AndrewJNg/Micromouse/99_Archieved/Micromouse/MicroMouse Wall/Wall Detector.jpg

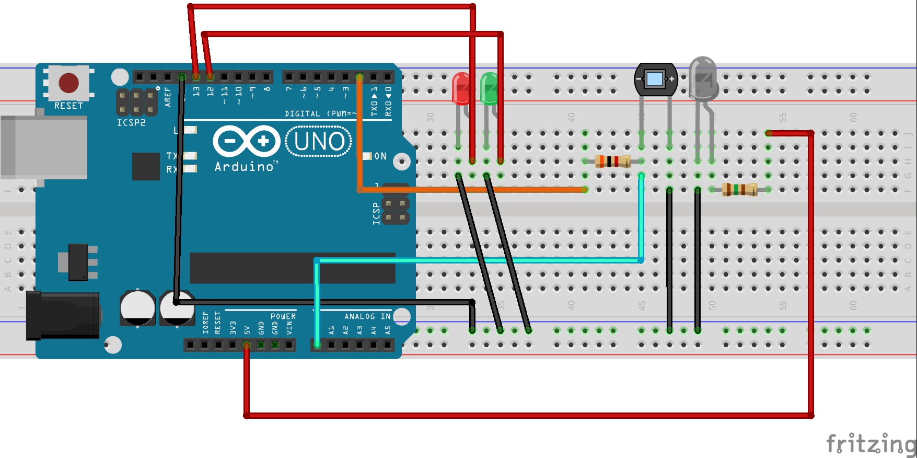
99_Archieved/Micromouse/MicroMouse Wall/Wall Detector.jpg
