AndrewJNg/Micromouse/99_Archieved/Micromouse/MicroMouse Line/Line Detector.jpg

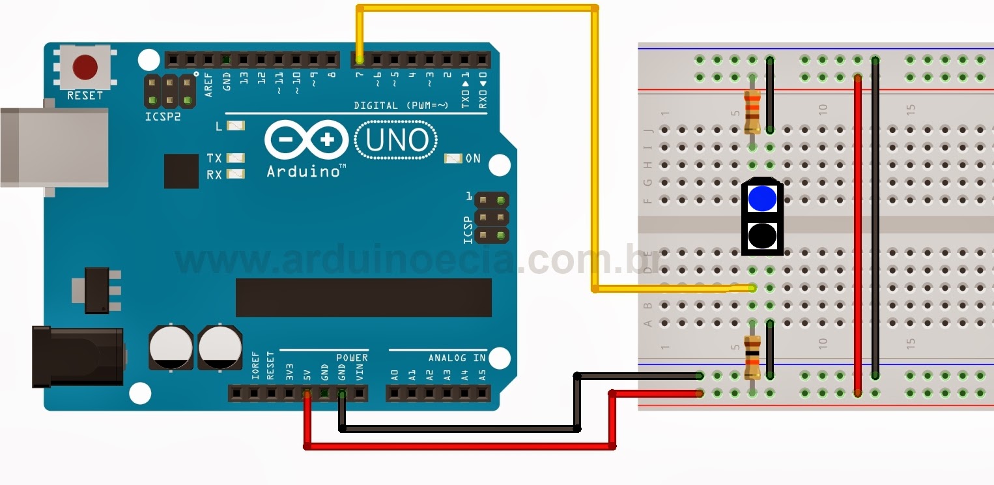
99_Archieved/Micromouse/MicroMouse Line/Line Detector.jpg
