AndrewJNg/Micromouse/README.md

# Micromouse
Micromouse alagorithm for solving a maze with known size

## Robot list: 
1. Homemade micromouse (Arduino Micro) 
2. ESP32 micromouse 

## Current prototype robot:
ESP32 micromouse
