AndrewJNg/Micromouse/99_Archieved/Micromouse/MicroMouse Line/arduino-maze-solver-master/arduino-maze-solver/README.md

# Arduino Maze Solver

- Uses Tremaux Algorithm to map a maze and then solve it
