AndrewJNg/Micromouse/1_Simulator/mms-python/README.md

# mms-python

Write a Micromouse maze-solving algorithm in Python.

For use with [mackorone/mms](https://github.com/mackorone/mms), a Micromouse simulator.

## Setup

1. Clone this repository
1. [Download the Micromouse simulator](https://github.com/mackorone/mms#download)
1. Run the simulator and click the "+" button to configure a new algorithm
1. Enter the config for your algorithm (name, directory, and run command)
1. Click the "Run" button

## Examples

Windows:



Linux (Ubuntu):



## Notes

- You may need to download and install [Python](https://www.python.org/downloads/)
- Spaces in file paths are not allowed, you may need to change the default Python install path
- Communication with the simulator is done via stdin/stdout, use stderr for logging
- Descriptions of all available API methods can be found at [mackorone/mms#mouse-api](https://github.com/mackorone/mms#mouse-api)
- The example code is a simple left wall following algorithm
