AndrewJNg/Micromouse/2_MambaMouse_V01/1_CAD_model/Renders/c1b7b31b-122d-4c15-ad1a-30528732baa7.PNG

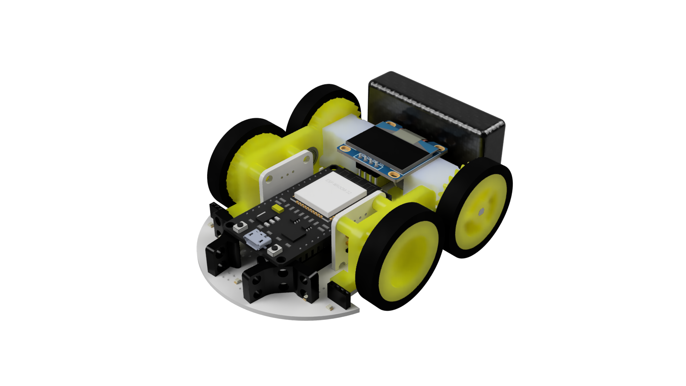
2_MambaMouse_V01/1_CAD_model/Renders/c1b7b31b-122d-4c15-ad1a-30528732baa7.PNG
