AndrewJNg/Micromouse/2_MambaMouse_V01/1_CAD_model/Renders/MambaMouse_Rev2 v11.png

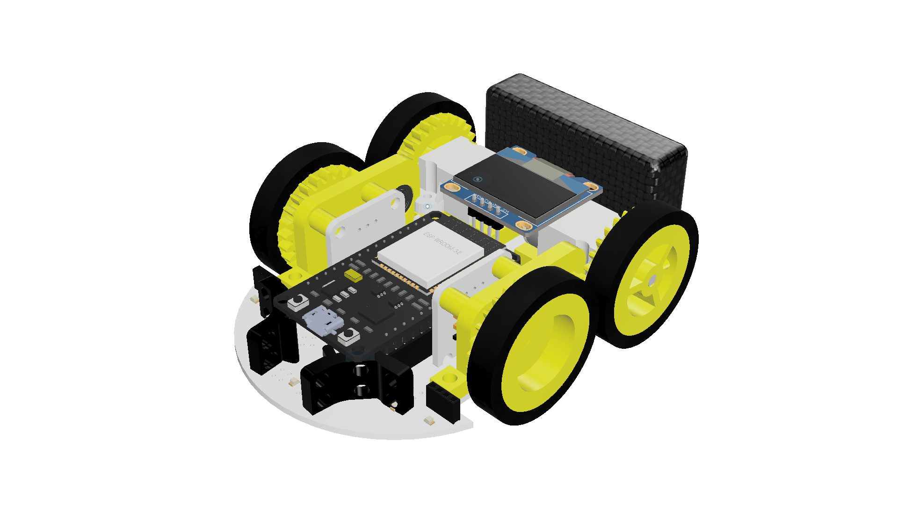
2_MambaMouse_V01/1_CAD_model/Renders/MambaMouse_Rev2 v11.png
