AndrewJNg/Micromouse/2_MambaMouse_V01/1_CAD_model/Renders/Screenshot 2024-06-14 232832.png

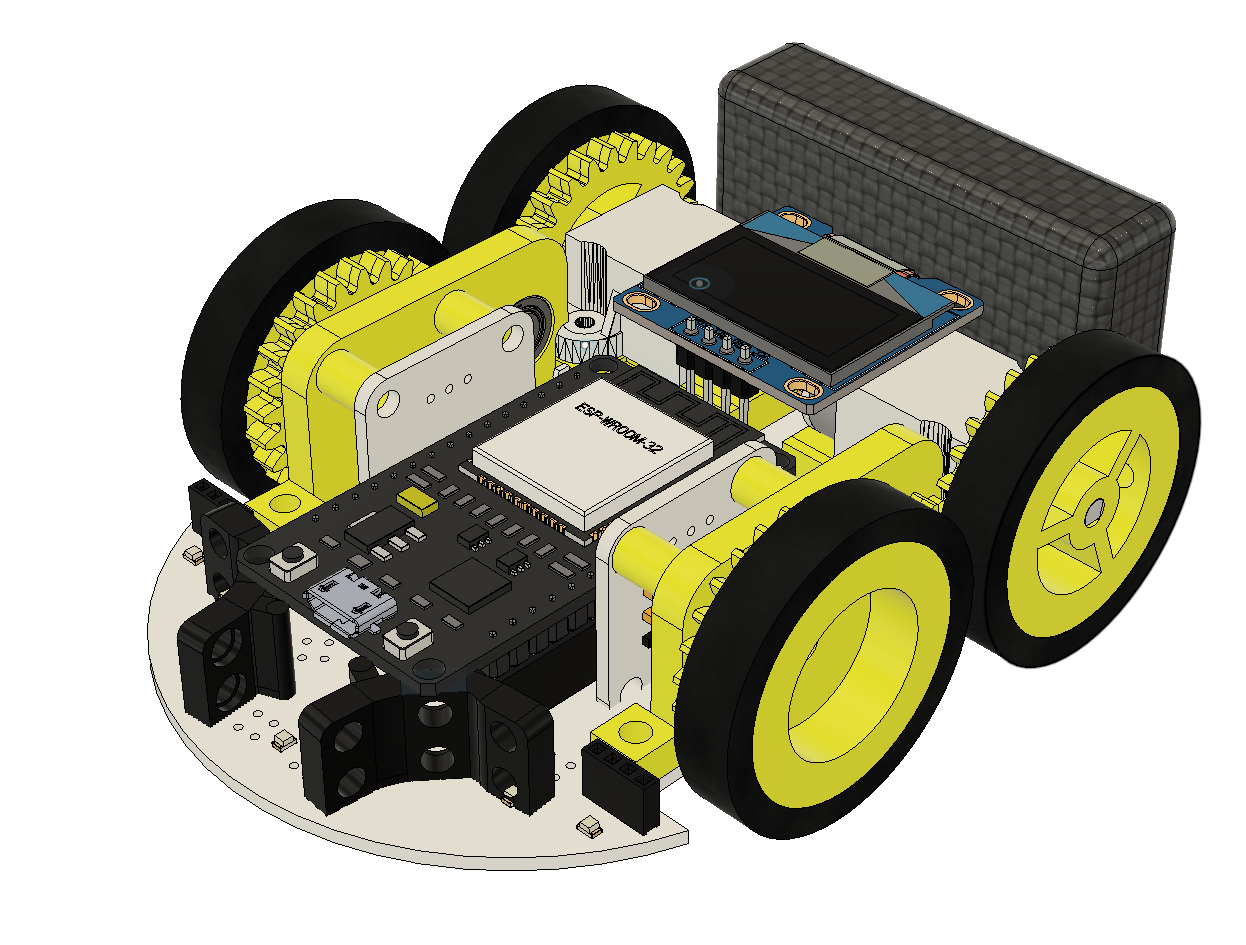
2_MambaMouse_V01/1_CAD_model/Renders/Screenshot 2024-06-14 232832.png
