AndrewJNg/Micromouse/2_MambaMouse_V01/1_CAD_model/STL/Right Motor mount (Right).3mf

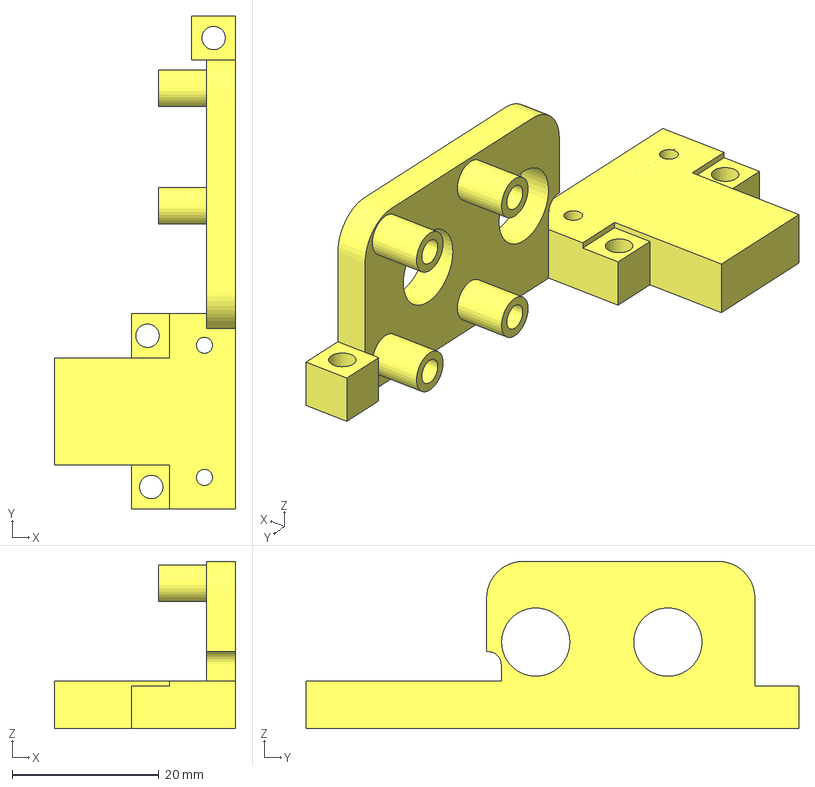
[picture p17: CAD file, 2024-10-26]
2_MambaMouse_V01/1_CAD_model/STL/Right Motor mount (Right).3mf
24.7 x 67.2 x 22.8 mm
