AndrewJNg/Micromouse/2_MambaMouse_V01/2_PCB_KiCad/KiCad/Micromouse_V01.step

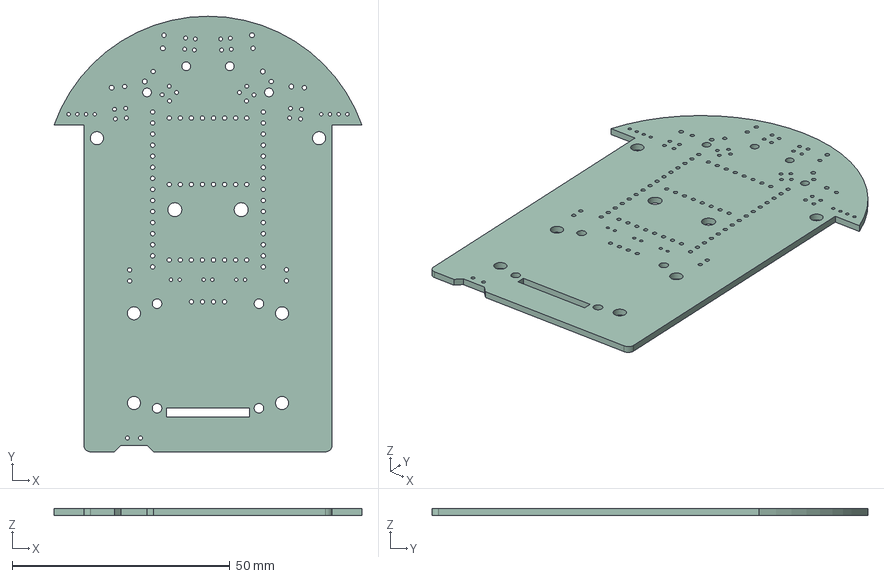
[picture p18: CAD file, 2026-08-18]
2_MambaMouse_V01/2_PCB_KiCad/KiCad/Micromouse_V01.step
70.7 x 100.0 x 1.51 mm
