AndrewJNg/Micromouse/2_MambaMouse_V01/1_CAD_model/STL/IR holder (Right).3mf

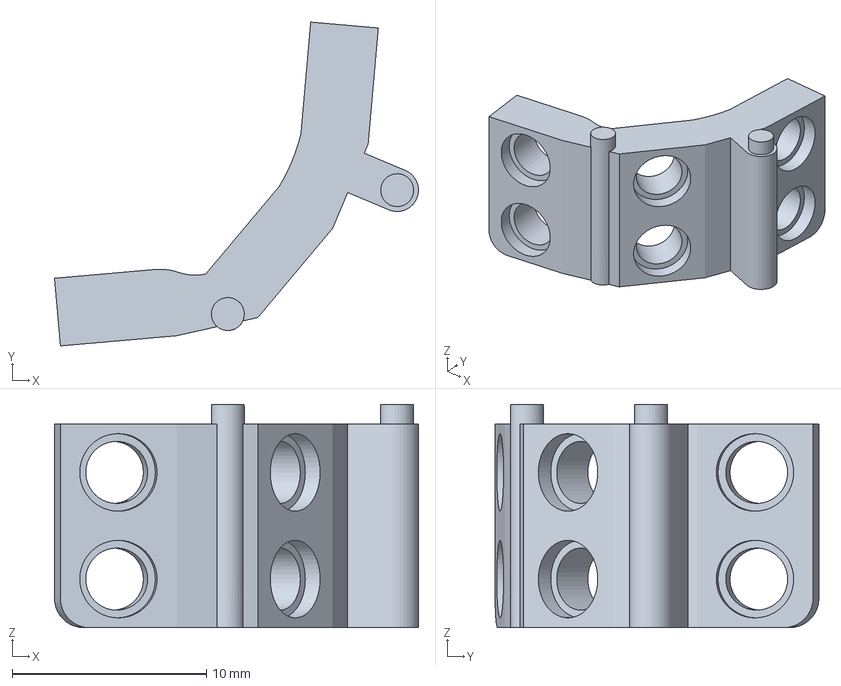
[picture p19: CAD file, 2024-10-26]
2_MambaMouse_V01/1_CAD_model/STL/IR holder (Right).3mf
18.8 x 16.7 x 11.5 mm
