AndrewJNg/Micromouse/2_MambaMouse_V01/1_CAD_model/STL/Rear Right Rim (Right).3mf

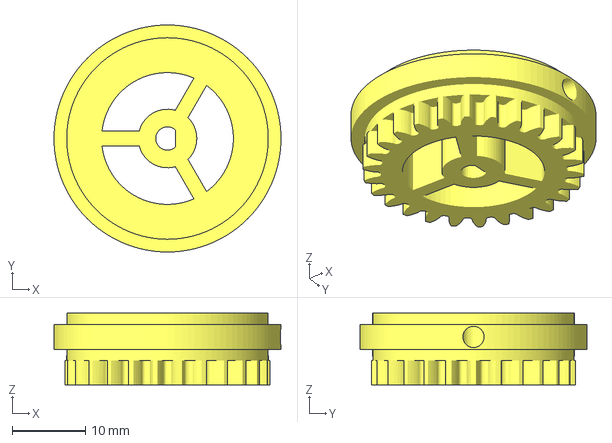
[picture p20: CAD file, 2024-10-26]
2_MambaMouse_V01/1_CAD_model/STL/Rear Right Rim (Right).3mf
31.0 x 31.0 x 9.80 mm
