AndrewJNg/Micromouse/2_MambaMouse_V01/1_CAD_model/STL/Spur Gear Right (Right).3mf

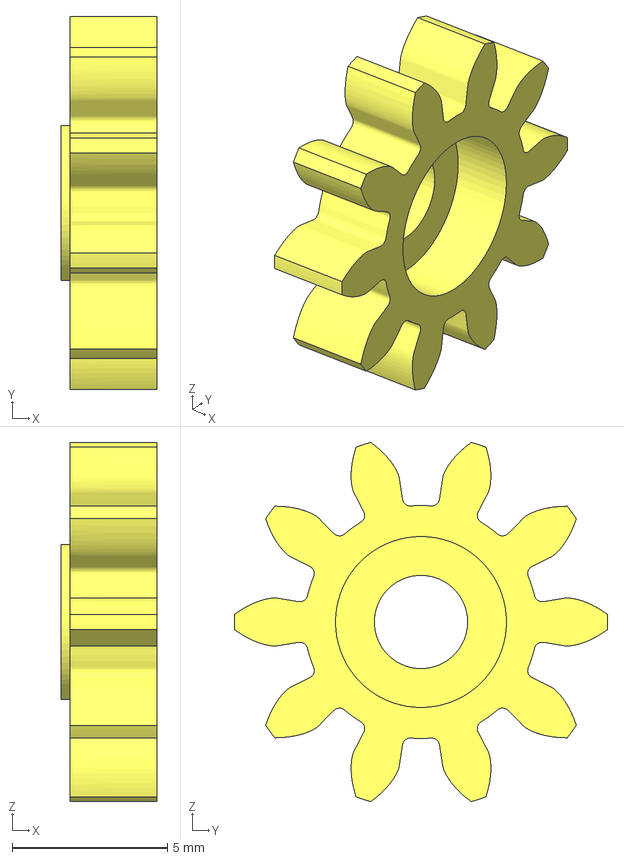
[picture p21: CAD file, 2024-10-26]
2_MambaMouse_V01/1_CAD_model/STL/Spur Gear Right (Right).3mf
3.10 x 12.0 x 11.6 mm
