AndrewJNg/Micromouse/2_MambaMouse_V01/1_CAD_model/STL/Front Right Rim (Right).3mf

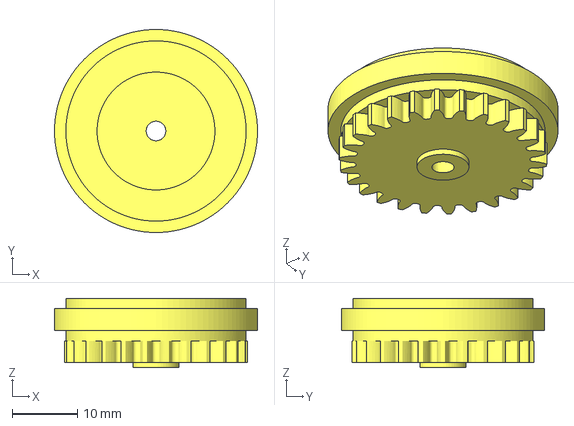
[picture p22: CAD file, 2024-10-26]
2_MambaMouse_V01/1_CAD_model/STL/Front Right Rim (Right).3mf
31.0 x 31.0 x 10.6 mm
