AndrewJNg/Micromouse/(list of files, cad)

Other CAD files:
2_MambaMouse_V01/1_CAD_model/MambaMouse_Rev2 v16.f3z
2_MambaMouse_V01/2_PCB_KiCad/KiCad/Micromouse_V01.stl
