AndrewJNg/Micromouse/2_MambaMouse_V01/4_Micromouse/subsystem_components/1_Drive_system/step_response_record/PWM_rates_Speed.png

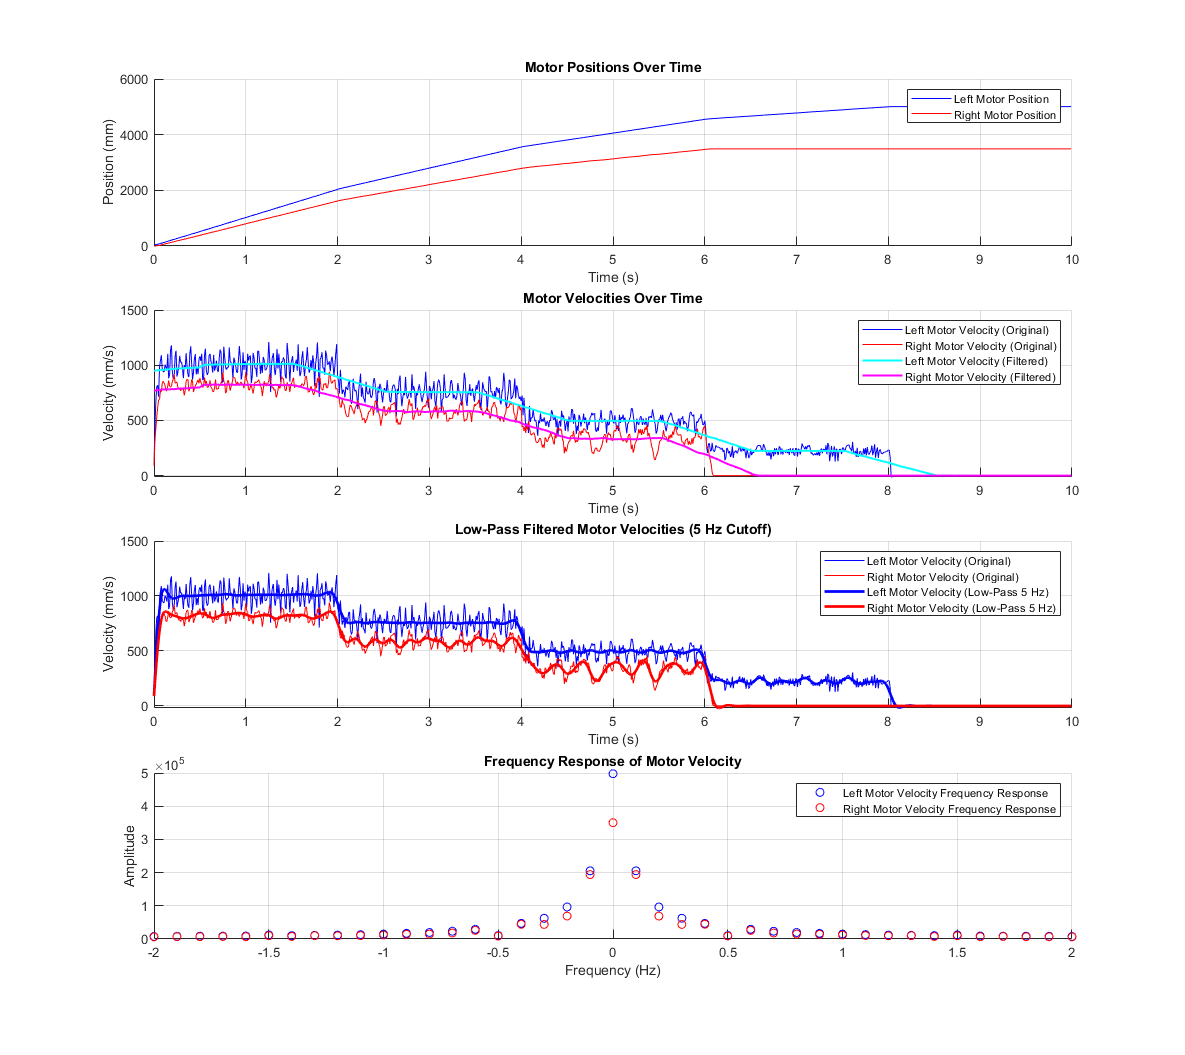
2_MambaMouse_V01/4_Micromouse/subsystem_components/1_Drive_system/step_response_record/PWM_rates_Speed.png
