AndrewJNg/Micromouse/2_MambaMouse_V01/2_PCB_KiCad/KiCad/Micromouse_V01.kicad_pcb

## KiCad design 2_MambaMouse_V01/2_PCB_KiCad/KiCad/Micromouse_V01.kicad_pcb (2024-09-08)

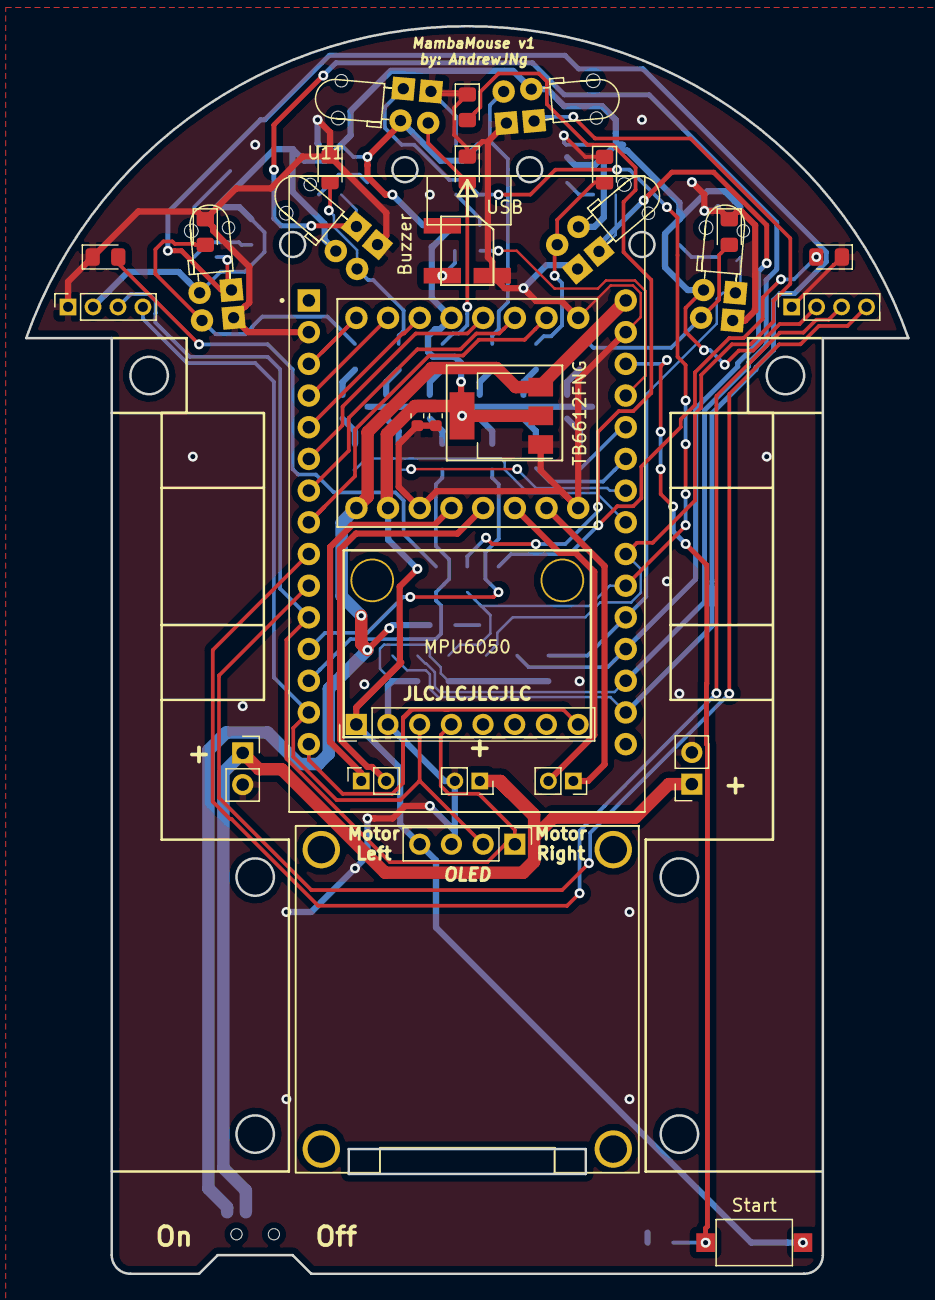
[picture p24: board Micromouse_V01.kicad_pcb from above]

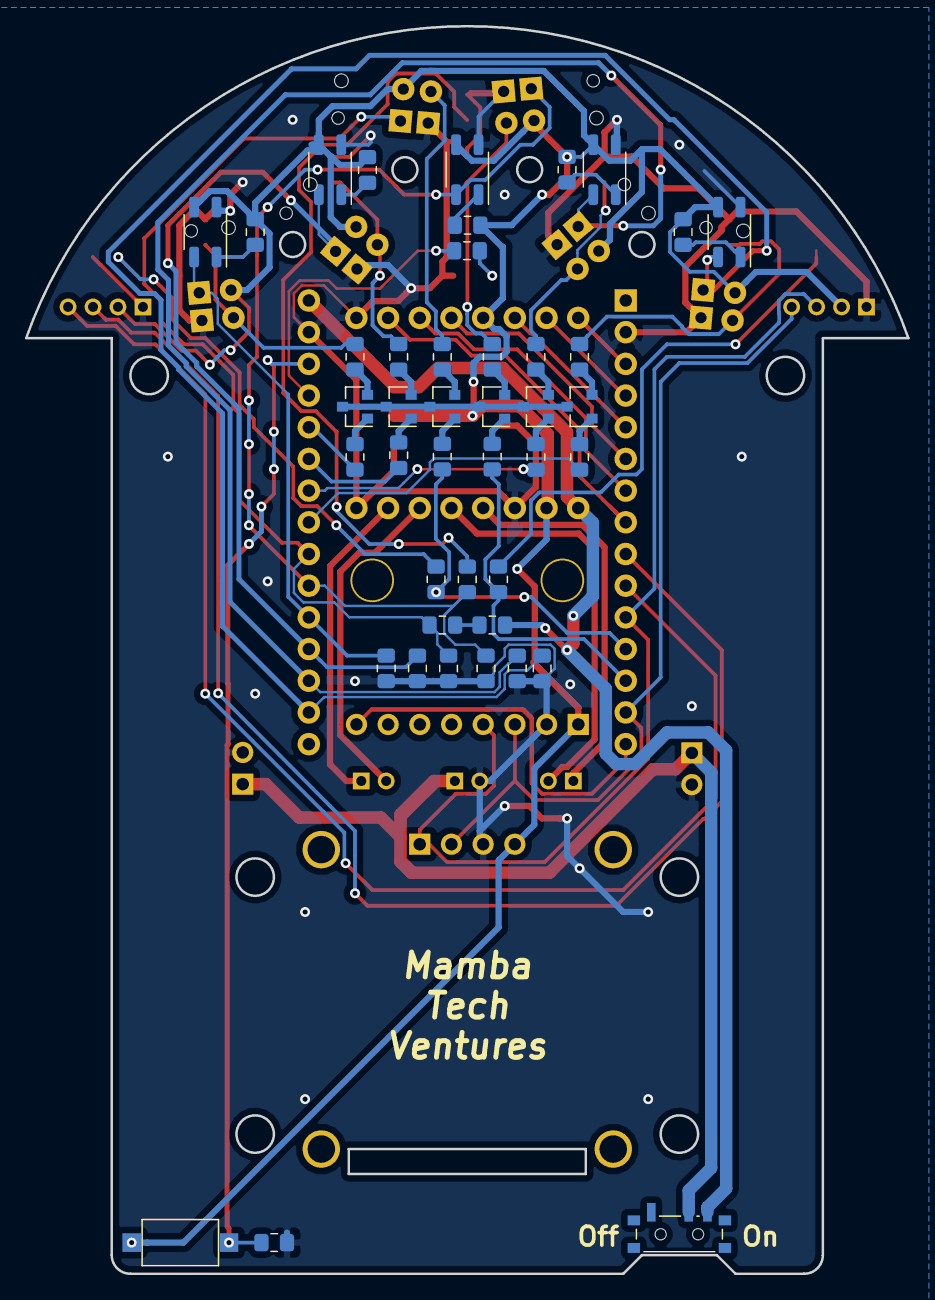
[picture p25: board Micromouse_V01.kicad_pcb from below]

Board: 2 copper layers, 70.7 x 100.0 mm, 73 parts (43 on the bottom side), 61 nets.

Parts:
BZ1: Buzzer; 4.2mm_5.5mm buzzer
C1, C2: 100nF; C_0603_1608Metric
D1, D2, D3, D4, D5, D6, D7, D8: LED; LED_0805_2012Metric_Pad1.15x1.40mm_HandSolder
J1, J7: Conn_01x02_Female; PinSocket_1x02_P2.54mm_Vertical
J2, J4, J8: Conn_01x02_Female; PinSocket_1x02_P2.00mm_Vertical
J3: OLED; OLED 128x32
J5: AS5600 Left; PinSocket_1x04_P2.00mm_Vertical
J6: AS5600 Right; PinSocket_1x04_P2.00mm_Vertical
Q1, Q2, Q3, Q4, Q5, Q6: Q_NPN_BEC; SOT-23
R1, R3, R5, R7, R9, R11, R15, R16, R17, R19, R26, R27, R28, R29, R30: 100; R_0805_2012Metric_Pad1.15x1.40mm_HandSolder
R2, R4, R6, R8, R10, R12, R13, R14, R18: 10K; R_0805_2012Metric_Pad1.15x1.40mm_HandSolder
R20, R21, R22, R23, R24, R25: 1k; R_0805_2012Metric_Pad1.15x1.40mm_HandSolder
S1, S2, S3, S4, S5, S6: 3mm_IR
S7, S8, S9, S10, S11: QRE1113; OnSemi_CASE100CY
SW1: SW_DPDT_x2; SW_SPDT_PCM12
SW2, SW3: Start; SW_SPST_CK_RS282G05A3
U1: AMS1117-3.3; SOT-223-3_TabPin2
U11: ESP32-WROOM; MODULE_ESP32_DEVKIT_V1
U12: TB6612FNG
U13: MPU-6050; MPU6050 module

Connections:
1: R15.1, R25.2, U11.35
2: U11.24, U12.22
3: R17.1, R20.2, U11.34
4: U11.26, U12.21
5: U11.29, U12.15
12: R19.1, U11.14
13: R18.2, SW2.2, SW3.2, U11.16
14: R24.2, U11.13
15: U11.23, U12.23
16: U11.27, U12.17
17: U11.28, U12.16
18_SDA2: J6.3, U11.30
19_SCL2: J6.4, U11.31
21_SDA1: J3.4, J5.3, U11.33, U13.24
22_SCL1: J3.3, J5.4, U11.36, U13.23
23: U11.37, U13.12
25: R21.2, U11.10
26: R22.2, U11.11
27: R23.2, U11.12
32: R10.1, R16.1, S5.3, S9.4, U11.8
33: R12.1, R14.2, S6.3, U11.9
34: R6.1, S3.3, S10.4, U11.6
35: R8.1, S4.3, S11.4, U11.7
36: R2.1, S1.3, S7.4, U11.4
39: R4.1, S2.3, S8.4, U11.5
+3V3: C1.1, C2.1, J3.1, J5.2, J6.2, Q1.3, Q2.3, Q3.3, Q4.3, Q5.3, Q6.3, R26.1, R27.1, R28.1, R29.1, R30.1, S1.4, S2.4, S3.4, S4.4, S5.4, S6.4, S7.3, S8.3, S9.3, S10.3, S11.3, SW2.1, SW3.1, U1.2, U12.19, U12.20, U13.13
+BATT: J1.1, J7.1, J8.1, SW1.2
GND: BZ1.2, C1.2, C2.2, D1.1, D2.1, D3.1, D4.1, D5.1, D6.1, D7.1, D8.1, J1.2, J3.2, J5.1, J6.1, J7.2, J8.2, R2.2, R4.2, R6.2, R8.2, R10.2, R12.2, R18.1, S1.1, S2.1, S3.1, S4.1, S5.1, S6.1, S7.2, S8.2, S9.2, S10.2, S11.2, U1.1, U11.15, U12.4, U12.9, U12.18, U13.18
unnamed: BZ1.1, R19.2
unnamed: D1.2, R15.2
unnamed: D2.2, R16.2
unnamed: D3.2, R17.2
unnamed: D4.2, R1.2, S1.2
unnamed: D5.2, R3.2, S2.2
unnamed: D6.2, R9.2, S5.2
unnamed: D7.2, R5.2, S3.2
unnamed: D8.2, R7.2, S4.2
unnamed: J2.1, U12.1
unnamed: J2.2, U12.5
unnamed: J4.1, U12.11
unnamed: J4.2, U12.7
unnamed: Q1.1, R21.1
unnamed: Q1.2, R1.1
unnamed: Q2.1, R22.1
unnamed: Q2.2, R3.1
unnamed: Q3.1, R23.1
unnamed: Q3.2, R5.1
unnamed: Q4.1, R24.1
unnamed: Q4.2, R7.1
unnamed: Q5.1, R25.1
unnamed: Q5.2, R9.1
unnamed: Q6.1, R20.1
unnamed: Q6.2, R11.1
unnamed: R11.2, S6.2
unnamed: R13.2, R14.1
unnamed: R26.2, S9.1
unnamed: R27.2, S7.1
unnamed: R28.2, S8.1
unnamed: R29.2, S10.1
unnamed: R30.2, S11.1
VCC: R13.1, SW1.3, U1.3, U11.32, U12.14
