AndrewJNg/Micromouse/2_MambaMouse_V01/2_PCB_KiCad/KiCad/noname.kicad_stable_v1_pcb.kicad_pcb

## KiCad design 2_MambaMouse_V01/2_PCB_KiCad/KiCad/noname.kicad_stable_v1_pcb.kicad_pcb (2022-12-16)

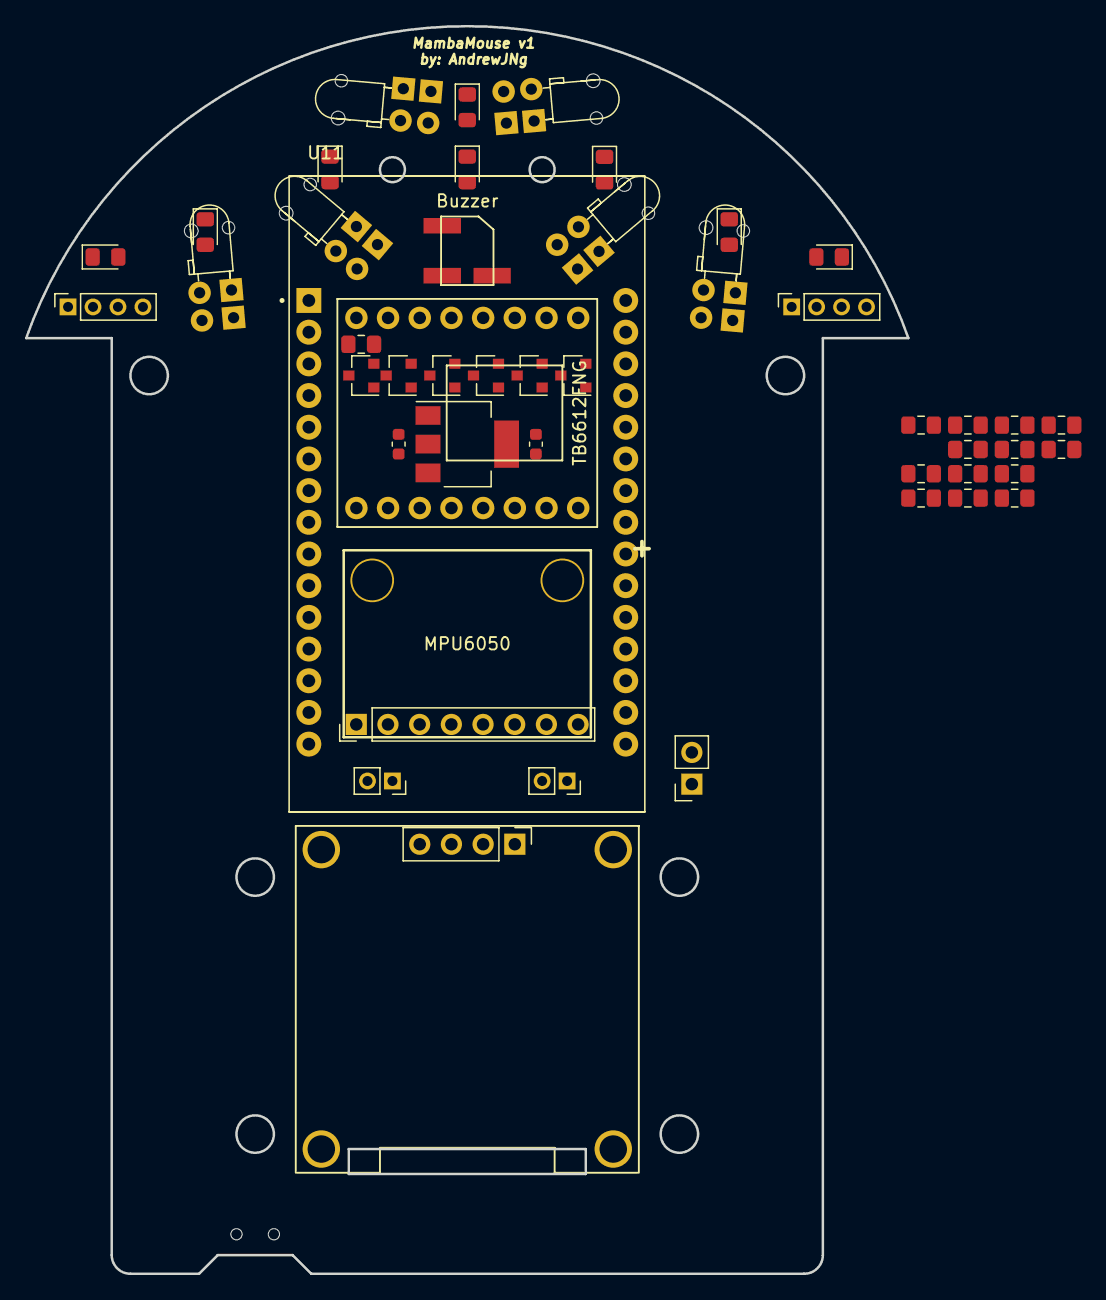
[picture p26: board noname.kicad_stable_v1_pcb.kicad_pcb from above]

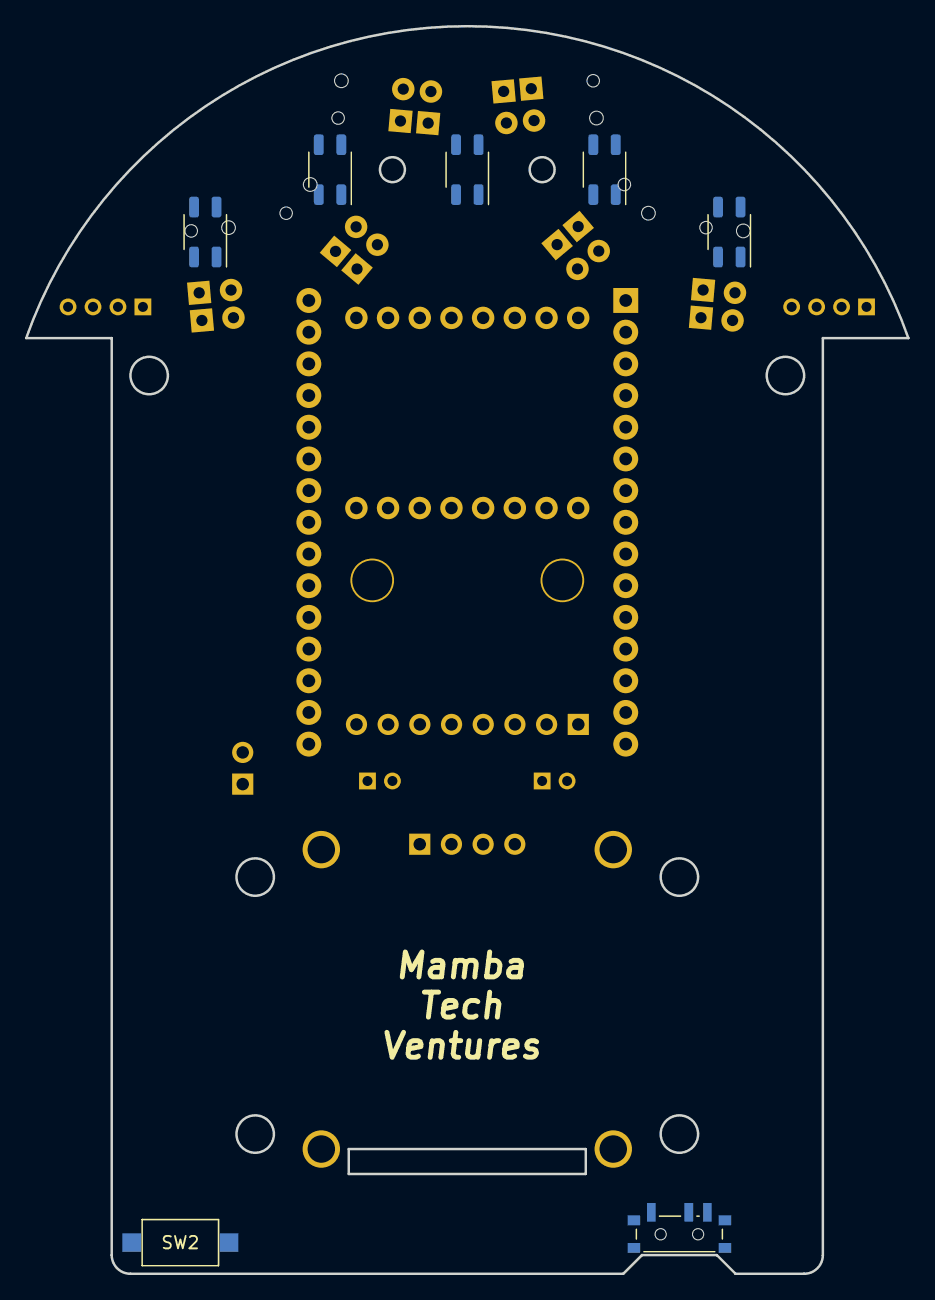
[picture p27: board noname.kicad_stable_v1_pcb.kicad_pcb from below]

Board: 2 copper layers, 70.7 x 100.0 mm, 54 parts (7 on the bottom side), 24 nets, no tracks yet.

Parts:
BZ1: Buzzer; 4.2mm_5.5mm buzzer
C1, C2: 100nF; C_0603_1608Metric
D1, D2, D3, D4, D5, D6, D7, D8: LED; LED_0805_2012Metric_Pad1.15x1.40mm_HandSolder
J1: Conn_01x02_Female; PinSocket_1x02_P2.54mm_Vertical
J2, J4: Conn_01x02_Female; PinSocket_1x02_P2.00mm_Vertical
J3: OLED; OLED 128x32
J5: AS5600 Right; PinSocket_1x04_P2.00mm_Vertical
J6: AS5600 Left; PinSocket_1x04_P2.00mm_Vertical
Q1, Q2, Q3, Q4, Q5, Q6: Q_NPN_BEC; SOT-23
R1, R3, R5, R7, R9, R11, R13: 10K; R_0805_2012Metric_Pad1.15x1.40mm_HandSolder
R2, R4, R6, R8, R10, R12, R14: 220; R_0805_2012Metric_Pad1.15x1.40mm_HandSolder
S1, S2, S3, S4, S5, S6: 3mm_IR
SW1: SW_DPDT_x2; SW_SPDT_PCM12
SW2: Start; SW_SPST_CK_RS282G05A3
U1: AMS1117-3.3; SOT-223-3_TabPin2
U2, U3, U8, U9, U10: QRE1113GR; OnSemi_CASE100CY
U11: ESP32-WROOM; MODULE_ESP32_DEVKIT_V1
U12: TB6612FNG
U13: MPU-6050; MPU6050 module

Connections:
+3V3: C1.1, C2.1, J3.1, Q1.3, Q2.3, Q3.3, Q4.3, Q5.3, Q6.3, S1.4, S2.4, S3.4, S4.4, S5.4, S6.4, U1.2
+BATT: J1.1, SW1.2
A0: R3.1, S1.3
A1: R5.1, S2.3
A2: R7.1, S3.3
A3: R9.1, S4.3
A6: R11.1, S5.3
A7: R13.1, S6.3
D8: R1.2, SW2.2
GND: BZ1.2, C1.2, C2.2, J1.2, J3.2, R1.1, R3.2, R5.2, R7.2, R9.2, R11.2, R13.2, S1.1, S2.1, S3.1, S4.1, S5.1, S6.1, U1.1
unnamed: BZ1.1, R14.2
unnamed: Q1.2, R2.1
unnamed: Q2.2, R4.1
unnamed: Q3.2, R6.1
unnamed: Q4.2, R8.1
unnamed: Q5.2, R10.1
unnamed: Q6.2, R12.1
unnamed: R2.2, S1.2
unnamed: R4.2, S2.2
unnamed: R6.2, S3.2
unnamed: R8.2, S4.2
unnamed: R10.2, S5.2
unnamed: R12.2, S6.2
VCC: SW1.1, U1.3
