AndrewJNg/Micromouse/99_Archieved/Micromouse/MicroMouse Line/Micromouse_line_tracer__V_1/Micromouse_line_tracer__V_1.ino

#include <SparkFun_TB6612.h>

#define PWMA 5
#define AIN2 6
#define AIN1 7
#define STBY 8
#define BIN1 9                                                  //motor 
#define BIN2 10
#define PWMB 11


const int offsetA = 1;
const int offsetB = 1;

Motor motorLeft = Motor(AIN1, AIN2, PWMA, offsetA, STBY);
Motor motorRight = Motor(BIN1, BIN2, PWMB, offsetB, STBY);


/////////////////////////////////////////////////////////////////////////////////////

int Button = 4;

int IR1 = A2;//left sensor                                                      //pin
int IR2 = A5;
int IR3 = A1;
int IR4 = A6;
int IR5 = A0;//right sensor


/////////////////////////////////////////////////////////////////////////////////////
//others

int L = 0;//Left
int S = 1;//Straight
int R = 2;//Right


/////////////////////////////////////////////////////////////////////////////////////





int SetPath[] = {
/*R,S,L,
R,
L,L,R,L,R,L,L,R,R,L,S,L,R*/




//L,S,S,R,L,L,R,R,L,R,L
//R,R,R,S,L





S,R,R,R,R,R
  
};





/////////////////////////////////////////////////////////////////////////////////////
int Time = 100;
int Speed = 255;
int different = 50;
int Turned = 0;
int TotalTurns = ((sizeof(SetPath)) / 2);
int turnSpeed = 100;
int Side = 1;

void setup() {
  pinMode(Button, INPUT);
  pinMode(IR1, INPUT);
  pinMode(IR2, INPUT);
  pinMode(IR3, INPUT);
  pinMode(IR4, INPUT);
  pinMode(IR5, INPUT);

  while (digitalRead(Button) == LOW); {
  }
  delay(2000);
}




void loop() {
       different=100;
       //lineFollow();
  if ((digitalRead(IR1) == 1) && (digitalRead(IR5) == 1)) {
    //Curve();
    lineFollow();
  }
  else {
    Brake();
    delay(1000);
    decision();
  }
}


void Curve(){
  if (Side == 1) {
    if (analogRead(IR2) >500) {
      different=510;
      turnLeft();
    }
    else {
      
      if (analogRead(IR3) <500) {
      turnRight();
    }
    else if (analogRead(IR3) >500) {
      turnLeft();
    }
    
    }
  }
  else if (Side == 0) {
    if (analogRead(IR4) >500) {
      different=510 ;
      turnRight();
    }
    else {

      if (analogRead(IR3) <500) {
      turnLeft();
    }
    else if (analogRead(IR3) >500) {
      turnRight();
    }
    
    }
  }

}
  
  




void lineFollow() {
  if (Side == 0) {
    if (digitalRead(IR3) ==1) {
      turnRight();
    }
    else if (digitalRead(IR3) ==0) {
      turnLeft();
    }
  }
  else if (Side == 1) {
    if (digitalRead(IR3) ==1) {
      turnLeft();
    }
    else if (digitalRead(IR3) ==0) {
      turnRight();
    }
  }

}








void turnLeft() {
  motorLeft.drive((Speed-different), 1);
  motorRight.drive(Speed, 1);
}
void turnRight() {
  motorLeft.drive(Speed, 1);
  motorRight.drive((Speed-different), 1);
}


void Brake() {
  digitalWrite(STBY, HIGH);

  digitalWrite(AIN1, HIGH);
  digitalWrite(AIN2, HIGH);
  analogWrite(PWMA, 255);

  digitalWrite(BIN1, HIGH);
  digitalWrite(BIN2, HIGH);
  analogWrite(PWMB, 255);
}

void decision() {
  if (Turned < TotalTurns) {
    if (SetPath[Turned] == 0) {
      //Left
      Left();
    }
    else if (SetPath[Turned] == 1) {
      //Straight
      Straight();
    }
    else if (SetPath[Turned] == 2) {
      //Right
      Right();
    }
  }

  else {
    //Stop
    Brake();

    while (digitalRead(Button) == LOW); {

    }
    Turned = -1;
  }


  Turned = Turned + 1;
}
void Left() {
  Brake();

  Brake();
  motorRight.drive(255, Time);

  Brake();
  while (digitalRead(IR3) ==0) {
    motorRight.drive(turnSpeed, 1);
  }
  Brake();
  Side = 0;
}

void Straight() {
  while ((digitalRead(IR1) == 1) || (digitalRead(IR5) ==1)) {
    lineFollow();
  }
}

void Right() {
  {
    Brake();

    Brake();
    motorLeft.drive(255, Time);
    Brake();
    while (digitalRead(IR3) == 0) {
      motorLeft.drive(turnSpeed, 1);
    }
    Brake();
    Side = 1;
  }
}
