AndrewJNg/Micromouse/2_MambaMouse_V01/4_Micromouse/subsystem_components/2_Infrared/IR_sensor_to_distance/IR_sensor.h

class IR_sensor {
    int point_num;  //set number of reading samples
    long values[100];
    long sum;
    int average;
    byte IR_pin;
    double a;
    double b;
    byte emitter_pin;

  public:
    IR_sensor(byte emitter, byte pin, int points, int value1, int value2)
    { // setup for IR receivers
      IR_pin = pin;
      point_num = points;
      sum = 0;
      average = 0;
      a = value1;
      b = value2;
      emitter_pin = emitter;
     pinMode(emitter_pin, OUTPUT);
    }

    double Distance()
    {
      //retrieve IR reading samples
     digitalWrite(emitter_pin, HIGH);
      delayMicroseconds(200);
      for ( int i = 0; i < point_num; i++ )
      {
        // values[i] = 4095 - analogRead(IR_pin);
        values[i] = analogRead(IR_pin);
      }
      delayMicroseconds(200);
     digitalWrite(emitter_pin, LOW);

      // obtain average value
      sum = 0;
      for ( int i = 0; i < point_num; i++ )  {
        sum +=  values[ i ];
//  Serial.println(sum);
      }
      average = sum / point_num;

  // Serial.print(average);
  // Serial.print("    ");
      //convert readings to distance in mm
      //      Serial.print(average);
      //      Serial.print("    ");
      int y = average;
      // double reading = a / (y - b);

      // double reading = a/log10(y) - b;
      double reading = y;
      //reading = 1/reading;
      //      double output = 36.8701/(1.0312e3*((1/y)-(1/1.0312e3)));
      // return y ;
      return reading ;
    }

};
