AndrewJNg/Micromouse/2_MambaMouse_V01/4_Micromouse/Micromouse_V1.2_esp32_mt6701/OLED.h

// OLED display
#include <Wire.h>
#include <Adafruit_GFX.h>
#include <Adafruit_SSD1306.h>

#define SCREEN_WIDTH 128
#define SCREEN_HEIGHT 64
#define OLED_RESET 15
Adafruit_SSD1306 OLED(SCREEN_WIDTH, SCREEN_HEIGHT, &Wire, OLED_RESET);

////////////////////////////////////////////////////////////////////////////////////////////////////////////////////////////////////////////////////////////////////////////////////////////////////////////////////////////////////////////////////////////////////////////////////////////////////////////////////////////////////////////////////////////////////////////////////////////////////////////////////////////////////////////////////////

unsigned long OledMillis = 0;
int OledInterval = 100;
static const unsigned char PROGMEM iQuick_logo[] = {  //iQuick Logo

  0x00, 0x00, 0x00, 0x00, 0x00, 0x00, 0x00, 0x00, 0x00, 0x00, 0x00, 0x00, 0x00, 0x00, 0x00, 0x00,
  0x00, 0x00, 0x00, 0x00, 0x00, 0x00, 0x00, 0x00, 0x00, 0x00, 0x00, 0x00, 0x00, 0x00, 0x00, 0x00,
  0x00, 0x00, 0x00, 0x00, 0x00, 0x00, 0x00, 0x00, 0x00, 0x00, 0x00, 0x00, 0x00, 0x00, 0x00, 0x00,
  0x00, 0x00, 0x00, 0x00, 0x00, 0x00, 0x00, 0x00, 0x00, 0x00, 0x00, 0x00, 0x00, 0x00, 0x00, 0x00,
  0x00, 0x00, 0x00, 0x00, 0x00, 0x00, 0x00, 0x00, 0x00, 0x00, 0x00, 0x00, 0x00, 0x00, 0x00, 0x00,
  0x00, 0x00, 0x00, 0x00, 0x00, 0x00, 0x00, 0x00, 0x00, 0x00, 0x00, 0x00, 0x00, 0x00, 0x00, 0x00,
  0x00, 0x00, 0x00, 0x00, 0x00, 0x00, 0x00, 0x00, 0x00, 0x00, 0x00, 0x00, 0x00, 0x00, 0x00, 0x00,
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
void OLED_menu_display() {



  if ((millis() > 3000) && (Start == LOW)) {
    OLED.clearDisplay();


    //////////////////////////////////////////////////////////////////////////////////////////
    // battery
    OLED.drawBitmap(103, 0, battery_logo, 25, 20, 1);

    OLED.setTextSize(1);
    OLED.setTextColor(SSD1306_WHITE);
    OLED.setCursor(106, 7);
    OLED.cp437(true);
    OLED.print(voltage_level(), 1);
    // OLED.print("%");

    //////////////////////////////////////////////////////////////////////////////////////////

    OLED.fillRect(0, 0, 20, 64, SSD1306_BLACK);

    OLED.drawRect(0, 0, 20, 16, SSD1306_WHITE);
    OLED.setTextSize(1);
    OLED.setTextColor(SSD1306_WHITE);
    OLED.setCursor(7, 4);
    OLED.cp437(true);
    OLED.write("4");

    OLED.drawRect(0, 15, 20, 16, SSD1306_WHITE);
    OLED.setTextSize(1);
    OLED.setTextColor(SSD1306_WHITE);
    OLED.setCursor(7, 19);
    OLED.cp437(true);
    OLED.write("3");

    OLED.drawRect(0, 31, 20, 16, SSD1306_WHITE);
    OLED.setTextSize(1);
    OLED.setTextColor(SSD1306_WHITE);
    OLED.setCursor(7, 35);
    OLED.cp437(true);
    OLED.write("2");

    OLED.drawRect(0, 47, 20, 16, SSD1306_WHITE);
    OLED.setTextSize(1);
    OLED.setTextColor(SSD1306_WHITE);
    OLED.setCursor(7, 51);
    OLED.cp437(true);
    OLED.write("1");

    for (int x = 1; x < 5; x++) {
      int y = 64 - (x * 16);
      if (Mode == x) {
        OLED.fillRect(0, y, 20, 16, SSD1306_WHITE);
        OLED.setTextSize(1);
        OLED.setTextColor(SSD1306_BLACK);
        //        OLED.setCursor(7, y - 12);
        OLED.setCursor(7, y + 4);
        OLED.cp437(true);
        OLED.write(x + 48);  // convert to ASCII number
      }
    }

    OLED.setTextColor(SSD1306_WHITE);
    OLED.cp437(true);
    if (Mode == 1) {

      OLED.setTextSize(1);
      OLED.setCursor(25, 20);
      OLED.println("Vel   = 1");
      OLED.setCursor(25, 30);
      OLED.println("Accel = 1");


      OLED.setTextSize(2);
      OLED.setCursor(25, 50);
      OLED.print("Search");
    } else if (Mode == 2) {

      OLED.setTextSize(1);
      OLED.setCursor(25, 20);
      OLED.println("Vel   = 1");
      OLED.setCursor(25, 30);
      OLED.println("Accel = 1");

      OLED.setTextSize(2);
      OLED.setCursor(25, 50);
      OLED.println("Speed");
    } else if (Mode == 3) {
      // OLED.drawBitmap(22, 35, Calibrate_Logo, 106, 30, 1);
      OLED.setTextSize(2);
      OLED.setCursor(25, 50);
      OLED.println("Calibr");
    } else if (Mode == 4) {
      OLED.setTextSize(2);
      OLED.setCursor(25, 30);
      OLED.println("PS3");
      OLED.setCursor(25, 50);
      OLED.print("controls");
    }
  }
  OLED.display();  //update the display
}


void OledTimer() {
  if (millis() - OledMillis >= OledInterval) {
    if ((Start == HIGH) && Mode != 4) {
      unsigned long RaceTime = millis() - StartTimer;
      unsigned long minutes = RaceTime / 60000;
      RaceTime -= minutes * 60000;
      unsigned long seconds = RaceTime / 1000;
      RaceTime -= seconds * 1000;
      unsigned long milliseconds = RaceTime;
      OLED.clearDisplay();
      if (minutes >= 100) {
        OLED.setTextSize(3);
        OLED.setTextColor(SSD1306_WHITE);
        OLED.setCursor(0, 0);
        OLED.cp437(true);
        OLED.print(minutes);
      } else if (minutes >= 10) {
        OLED.setTextSize(4);
        OLED.setTextColor(SSD1306_WHITE);
        OLED.setCursor(0, 0);
        OLED.cp437(true);
        OLED.print(minutes);
      } else {
        OLED.setTextSize(4);
        OLED.setTextColor(SSD1306_WHITE);
        OLED.setCursor(23, 0);
        OLED.cp437(true);
        OLED.println(getPosition);
        OLED.print(minutes);
      }



      if (seconds >= 10) {
        OLED.print(":");
        OLED.println(seconds);
      } else {
        OLED.print(":0");
        OLED.println(seconds);
      }

      if (milliseconds >= 100) {
        OLED.setTextSize(3);
        OLED.setCursor(50, 40);
        OLED.print(":");
        OLED.print(milliseconds);
      } else if (milliseconds >= 10) {
        OLED.setTextSize(3);
        OLED.setCursor(50, 40);
        OLED.print(":0");
        OLED.print(milliseconds);
      } else if (milliseconds >= 1) {
        OLED.setTextSize(3);
        OLED.setCursor(50, 40);
        OLED.print(":00");
        OLED.print(milliseconds);
      } else {
        OLED.setTextSize(3);
        OLED.setCursor(50, 40);
        OLED.print(":000");
      }





      OLED.display();  //update the display
    }
    OledMillis = millis();
  }
}



void OLED_display_stats() {
  static unsigned long prevMillis = 0;
  unsigned long currentMillis = millis();

  // OLED display refresh at 10Hz
  if (currentMillis - prevMillis >= 100) {
    prevMillis = currentMillis;
    unsigned long timeRecord = micros();

    OLED.clearDisplay();

    OLED.setTextSize(1);               // Normal 1:1 pixel scale
    OLED.setTextColor(SSD1306_WHITE);  // Draw white text
    OLED.setCursor(0, 0);              // Start at top-left corner

    ////////////////////////////////////////////////////////////////////////////////////////////////////////////////////////////////////////////////////////////////////////////////////////////////////////////////////////////////////////////////////////////////////////////////////////////////////////
    // motor & encoder

    ////////////////////////////////////////////////////////////////////////////////////////////////////////////////////////////////////////////////////////////////////////////////////////////////////////////////////////////////////////////////////////////////////////////////////////////////////////
    // IR
    OLED.print("IRFront:  ");
    OLED.print(map(IRVal[0] * 100, 0, 10000, 0, 4095), 0);
    OLED.print("  ");
    OLED.println(map(IRVal[5] * 100, 0, 10000, 0, 4095), 0);

    OLED.print("IR45:     ");
    OLED.print(map(IRVal[1] * 100, 0, 10000, 0, 4095), 0);
    OLED.print("  ");
    OLED.println(map(IRVal[4] * 100, 0, 10000, 0, 4095), 0);

    // OLED.print("IRSide:   ");
    // OLED.print(map(IRVal[2] * 100, 0, 10000, 0, 4095), 0);
    // OLED.print("  ");
    // OLED.println(map(IRVal[3] * 100, 0, 10000, 0, 4095), 0);
    
    OLED.print("IRFront:  ");
    OLED.print(IRDistance[0], 0);
    OLED.print("  ");
    OLED.println(IRDistance[5],0);

    OLED.print("IR45:     ");
    OLED.print(IRDistance[1],0);
    OLED.print("  ");
    OLED.println(IRDistance[4],0);

    // OLED.print("IRSide:   ");
    // OLED.print(IRDistance[2],0);
    // OLED.print("  ");
    // OLED.println(IRDistance[3],0);


    ////////////////////////////////////////////////////////////////////////////////////////////////////////////////////////////////////////////////////////////////////////////////////////////////////////////////////////////////////////////////////////////////////////////////////////////////////////
    // Gyro
    //    OLED.println("Gyro    ");
    //    OLED.println("  ");
    //    OLED.print("X:");
    //    OLED.print( gyroX, 1);
    //    OLED.print(" Y:");
    //    OLED.print( gyroY, 1);
    //    OLED.print(" Z:");
    //    //    OLED.println( gyroZ, 1);
    //    OLED.println( MPU_Z_angle(), 1);

    //    OLED.print("OLED: ");
    //    OLED.println(micros() - timeRecord);

    // OLED.print("P: ");
    // OLED.println(leftMotor.PID_Kp, 5);
    // OLED.print("I: ");
    // OLED.println(KiLeft, 5);
    // OLED.print("D: ");
    // OLED.println(KdLeft, 5);


    // OLED.print("Gyro: ");
    // OLED.println(gyroZ, 2);


    // OLED.print("L: ");
    // OLED.print(leftMotor.angle2mm());
    // OLED.print(" R: ");
    // OLED.println(rightMotor.angle2mm());



    // OLED.print("L: ");
    // OLED.print(leftMotor.updateEncoder());
    // OLED.print(" R: ");
    // OLED.println(rightMotor.updateEncoder());

    OLED.print("L: ");
    OLED.print(leftMotor.measured_velocity);
    OLED.print(" R: ");
    OLED.println(rightMotor.measured_velocity);


    // OLED.print("L: ");
    // OLED.print(leftMotor.angle2mm());
    // OLED.print(" R: ");
    // OLED.println(rightMotor.angle2mm());

    /*
     
    OLED.print("P: ");
    OLED.println(straightKp,5);
    OLED.print("I: ");
    OLED.println(straightKi,5);
    OLED.print("D: ");
    OLED.println(straightKd,5);
     */
    //    OLED.print("P: ");
    //    OLED.println(Kp);
    //    OLED.print("I: ");
    //    OLED.println(Ki);
    //    OLED.print("D: ");
    //    OLED.println(Kd);

    //    OLED.print(" Set: ");
    //    OLED.println( Setpoint);
    //    OLED.print(" Z: ");
    //    OLED.println( MPU_Z_angle(), 1);


    OLED.display();
  }
}


void OLED_setup() {

  // User_interface setup
  if (!OLED.begin(SSD1306_SWITCHCAPVCC, 0x3C)) {  // Address 0x3C for 128x64
    Serial.println(F("SSD1306 allocation failed"));
    for (;;)
      ;  // Don't proceed, loop forever
  }
  //   if (!OLED.begin(
  //     SSD1306_SWITCHCAPVCC,
  //     0x3C,
  //     true,   // reset
  //     false   // DON'T call Wire.begin() internally
  // )) {

  //     Serial.println("SSD1306 allocation failed");

  //     for (;;);
  // }
  OLED.clearDisplay();
  OLED.display();

  //show logo
  OLED.clearDisplay();
  OLED.drawBitmap((OLED.width() - 128) / 2, (OLED.height() - 64) / 2, iQuick_logo, 128, 64, 1);
  OLED.setTextSize(1);               // Normal 1:1 pixel scale
  OLED.setTextColor(SSD1306_WHITE);  // Draw white text
  OLED.setCursor(45, 50);
  OLED.cp437(true);  // Use full 256 char 'Code Page 437' font
  OLED.print("iQuick");
  OLED.display();
}
