AndrewJNg/Micromouse/(commit log)

2022-02-17 Develop the ESP32 arduino code to solve real world maze
2022-02-17 counter mistake in adding arduino ESP32 micromouse code
    [AS5600.h, AS5600_motor_encoder_pwm_mode.ino, DifferentialDrive.cpp, DifferentialDrive.h, Encoder.h, FloodFill.h, IR_sensor.h, IR_sensor_to_distance.ino]
2022-07-04 Made first version with fundamental components list, with raw sensor inputs
2022-07-04 improved on as5600 encoder sensing, made it so encoder have a menu counter and a high speed motor counter
2022-07-05 cleaned up the main file, calculation for speed using encoders, aligning to front wall using infrared values and simple proportional code, added cell_mevement which allows for maze movements and turn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
2022-07-06 added maze centering (keep robot in the middle of walls), added menu system using ps3 controller to change mode, and OLED menu from mamba Samurai robot, added ps3 battery monitoring to show on OLED
2022-07-07 added PID library and ps3 support for easy kp ki kd value change along with displaying the values on the OLED display. Button class was made to allow easy changes using inputs from different IR senso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
2022-07-08 made a semi successful velocity control system (encoder seems to be jumping every now and again, PID could be improved as one motor is faster thatn the other still)
2022-07-08 moved the speed monitoring system to a function in speed_profile, removed the IR sensor as they are blocking the code, which improves the calculation for the wheel
2022-07-09 found the main bug for encoder skips (added equal sign to encoder reading statement), commented out encoder motor as the speed improvement from the previous days for as5600 configuration has eliminat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
    [AS5600.h, Cell_movement.h, Micromouse_V1-esp32.ino, Movement.h, PS3.h, Speed_profile.h]
2022-07-09 combined menu encoder update and enc motor update, as it is not needed anymore as the i2c speed of as5600 is able to support the speed needed
2022-07-09 improved turn() fucntion using PID tuning
2022-07-13 made lots of changes, main addition is to use pointers as map variable, made a c++ file for pointers in another file, refined movement functions to be able to swap between alignment tools based on wa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
    [Cell_movement.h, Infrared.h, Micromouse_V1-esp32.ino, Movement.h, OLED.h, PID.h, PS3.h]
2022-12-16 added in V1 PCB design files
    [A3906.sch, Anduino.sch, Esp32.sch, IRsensor.sch, MPU6050.sch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]
2023-01-18 added mamba mouse line tracer, made another PID control system using arduino PID library
2023-06-03 made minor changes to the code for different modes, added a new combined sensor mount for ir sensors
2023-06-13 added memory storage, refined linear infrared sensing with normalised values, used simpler lowPass filter function online, added encoder menu system to swap between modes and use right infrareds for 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
    [AS5600.h, Cell_movement.h, FloodFill.h, Infrared.h, Micromouse_V1-esp32.ino, Movement.h, OLED.h, PID.h]
2024-09-08 backup after long time, to update kicad
    [Esp32.kicad_sch, IRsensor.kicad_sch, MPU6050.kicad_sch, Micromouse_V01.kicad_pcb, Micromouse_V01.kicad_sch, TB6612FNG.kicad_sch]
2024-10-26 Clean up repo files and versions
    [A3906.sch, Anduino.sch, Esp32.kicad_sch, Esp32.sch, Front Right Rim (Right).3mf, IR holder (Right).3mf, IRsensor.kicad_sch, IRsensor.sch]
2024-10-26 issue with encoder, next step is to make it a class
    [Micromouse_V1-esp32.ino, Movement.h, PS3.h]
2024-10-26 moved motor pwm to 12 bit, 4096 steps for better motor control
2024-10-28 made a subsystem function, with encoder and motor built together as a class,
    [encoder_data.csv, encoder_data2.csv, encoder_data3.csv, encoder_data4.csv, encoder_data5.csv, encoder_data6.csv, step_full.csv, step_half.csv]
2024-10-28 removed commented out code, and add lowpass filter to encoder wheel
2024-10-28 generated trapezoidal velocity profile, combined method works quite well, however there is a motor loading issue, feedforward a term not tuned, and PID values are not tuned, however gave 10cm precisi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
    [encoder_data10.csv, encoder_data11.csv, encoder_data12.csv, encoder_data13.csv, encoder_data14.csv, encoder_data15.csv, encoder_data7.csv, encoder_data8.csv]
2026-08-18 organized file system, clean up main micromouse code, library access order, updated polynomial for IR sensor reading
    [A3906.sch, Anduino.sch, Esp32.kicad_sch, Esp32.sch, Front Right Rim (Right).3mf, IR holder (Right).3mf, IRsensor.kicad_sch, IRsensor.sch]
2026-08-23 worked on PID and FF tuning for motion system, along with Infrared calibration routine, added micromouse maze database for simulation practice
    [maze-wall-count-distribution.ods]
2026-08-23 got PID tuning with positional control working, next step is to clean positional code and implement angular control
2026-08-30 added version with MT6701 absolute encoder for drive system
2026-08-30 enabled battery monitor pin, and remove accel variable in Feedforward function
2026-09-13 added in infrared reference values for single point reference, and reduced motors to 200RPM for now, lastly fixed a bug with I2C encoder being interrupted by OLED reset pin, which is unused
    [Bluetooth_serial_2_csv.py, Infrared.h, Micromouse_V1.2_esp32_mt6701.ino, Motor_Subsystem.h, OLED.h]
2026-09-22 added back low pass filter, and diagnosed that periodic interrupt in speed is caused by bluetooth, to use a different core for movement
    [serial_data2.csv, speed_data.csv]
2026-09-26 adjusted kd value to adjust to the correct voltage range
    [serial_data2.csv]
